arthurmlima/iceOv7670Tft/README.md

# Tang Primer 25K OV7670 → ST7789 Live Camera Stream

Pure-Verilog live camera viewfinder for the **Sipeed Tang Primer 25K**
(Gowin GW5A-25A, on the 25K Dock): an OV7670 camera is streamed straight to
an ST7789 TFT/IPS panel with **no CPU, no external RAM, and no full frame
buffer**. The ST7789's own GRAM is the frame store; the FPGA only carries a
small FIFO to absorb the difference between the camera's bursty active-video
timing and the panel's constant SPI drain rate.

```text
OV7670 RGB565 → center-crop 320×240 to 280×240
              → optional frame-seeded XOR-map stage
              → 32768×16 synchronous FIFO (32 GW5A BSRAM)
              → ST7789 RAMWR stream
```

Top-level entity: **`tangprimer25k_st7789_top`**
(`tangprimer25k_st7789_top.v`).

This design was originally built for the iCEBreaker (Lattice iCE40UP5K) and
ported here. [§12](#12-what-the-port-changed) is the summary of what had to
change and why; everything between the top level and the pads is the same RTL.

---

## 1. Repository layout

| Path | Role |
|---|---|
| `tangprimer25k_st7789_top.v` | Top level: PLL, POR/reset, camera XCLK, ODDR SPI pad cells, SCCB IO buffer, buttons, status LEDs |
| `gowin_pll_40m.v` | `PLLA` wrapper: 50 MHz dock oscillator → 40 MHz `clk_sys` |
| `btn_debounce.v` | Synchronizer + integrate-and-commit debouncer for one pushbutton |
| `status_led.v` | Turns the two board LEDs into a frame heartbeat and a blink-coded fault index |
| `test_pattern_src.v` | Frame-static diagnostic pattern with the camera's exact timing |
| `tangprimer25k_pattern_top.v` | Diagnostic top: same design, `test_pattern_src` instead of the camera |
| `cam_init.v` | OV7670 SCCB (I²C-like) master — writes the register table on power-up |
| `cam_capture.v` | Synchronizes PCLK/HREF/VSYNC, assembles RGB565 bytes, crops 320→280 columns |
| `frame_stream_gate.v` | Atomically accepts a frame only when the display is ready; drops busy-time frames without flushing/mixing FIFO data |
| `pixel_xor_stage.v` | Per-frame seed generator, frame-safe bypass mux, and pixel/XOR-map integration |
| `xormap_32.v` | Iterative 32-bit XOR map with a 16-bit folded output |
| `pixel_fifo.v` | 32768×16 single-clock FIFO absorbing the camera/panel rate difference (infers 32 BSRAM) |
| `st7789_camera_ctrl.v` | ST7789 reset/init/address-window FSM, streams FIFO pixels into RAMWR |
| `st7789_init_rom.v` | Combinational ROM: the known-working ST7789 register-init sequence |
| `spi_stream_tx.v` | Gapless mode-0 SPI byte engine, one bit per `clk_sys` cycle; device-independent (the DDR pad cells live in the top level) |
| `tangprimer25k.cst` | Physical constraints — pin table in [§7](#7-wiring--pinout) |
| `tangprimer25k.sdc` | Timing constraints |
| `tangprimer25k.gprj` | Gowin project file (device + source list) |
| `build.tcl` | Headless `gw_sh` script: sets the dedicated-pin overrides, then `run all` |
| `Makefile` | `gw_sh` → `openFPGALoader` build/program flow, plus `sim` and `timing` |
| `tb_spi_gowin_io.v` | Pad-level testbench for the ODDR SPI cells (see [§4.2](#42-spi-pad-cells-sb_io--oddr)) |
| `tb_frame_recovery.v` | Reproduces the starved-frame deadlock and proves the watchdog clears it |
| `build_pattern.tcl` | `build.tcl` with the diagnostic top selected |
| `timing_check.py` | Recomputes the clock/line-rate/FIFO-margin numbers in [§4](#4-clock-plan) and [§5](#5-line-rate-proof) |
| `docs/SETUP.md` | One-time Gowin CLI toolchain setup on macOS, and board notes |
| `docs/install-gowin-cli.sh` | Idempotent installer for that setup |
| `unused/` | RTL **not** part of the build — see [§1.1](#11-unused--reference-rtl) |

### 1.1 Unused / reference RTL

`unused/` holds the earlier standalone ST7789 test-pattern design this was
built from, plus the retired iCE40 build. None of it is in the Makefile's
`SOURCES` list or `tangprimer25k.gprj`.

| Path | Role |
|---|---|
| `unused/icebreaker_st7789_top.v` | The iCE40UP5K top level this port replaced (`SB_PLL40_PAD` + `SB_IO` cells) |
| `unused/icebreaker.pcf` | Its nextpnr pin constraints |
| `unused/st7789_rgb_test.v` | Old standalone top: reset + init ROM + CASET/RASET/RAMWR + a combinational test-pattern generator, no camera |
| `unused/rgb_test_pattern.v` | Combinational RGB565 test-pattern generator instantiated only by `st7789_rgb_test.v` |
| `unused/spi_master_tx.v` | Older one-cycle-per-bit SPI engine (superseded by `spi_stream_tx.v`'s DDR engine) |
| `unused/timing_39MHz.patch` | Historical iCE40 PLL patch, kept only for the record |

---

## 2. Module tree

```text
tangprimer25k_st7789_top                     (PLL, POR/reset, XCLK gen, LEDs, pad cells)
│
├─ gowin_pll_40m  "pll"                       50 MHz → 40 MHz clk_sys
│    └─ PLLA                                  [GW5A primitive]
│
├─ btn_debounce  "s2_button"                  S2 → one clean toggle pulse per press
│
├─ status_led  "status"                       frame heartbeat + blink-coded fault
│
├─ cam_init  "camera_config"                  OV7670 SCCB register-write master
│    (drives cam_sioc directly; siod_low → IOBUF below)
│
├─ IOBUF  "cam_siod_io"                       [GW5A primitive] open-drain SCCB data pin
│
├─ cam_capture  "capture"                     RGB565 capture / crop / frame-sync
│    (enable = stream_enable = cam_cfg_done && lcd_init_done)
│
├─ frame_stream_gate  "frame_gate"            accept ready frames / drop busy frames
│
├─ pixel_xor_stage  "encryption"              optional frame-seeded pixel XOR
│    └─ xormap_32  "map"                      iterative 32-bit XOR map
│
├─ pixel_fifo  "fifo"                         32768×16 surplus FIFO (32 BSRAM)
│
├─ st7789_camera_ctrl  "display"              ST7789 reset/init/window/pixel-stream FSM
│    ├─ st7789_init_rom  "init_rom"           combinational panel-init byte ROM
│    └─ spi_stream_tx  "spi"                  gapless mode-0 SPI bit engine
│
├─ ODDR  "tft_sclk_io"                        [GW5A primitive] → tft_scl  (SCLK)
├─ ODDR  "tft_mosi_io"                        [GW5A primitive] → tft_sda  (MOSI)
├─ ODDR  "tft_dc_io"                          [GW5A primitive] → tft_dc
└─ ODDR  "tft_cs_io"                          [GW5A primitive] → tft_cs
```

`tft_res` and `tft_blk` are driven straight from the top level; they only move
on millisecond timescales, so they need no pad retiming.
`tft_blk` is `assign tft_blk = BL_ACTIVE_HIGH ? bl_raw : ~bl_raw;`, where
`bl_raw` comes from `st7789_camera_ctrl`'s `tft_bl` output.

---

## 3. Block diagram

```mermaid
flowchart LR
    subgraph CLK["Clock generation"]
        OSC["50 MHz\ndock oscillator (E2)"] --> PLL["PLLA\nIDIV=1 FBDIV=1\nMDIV=24 ODIV0=30"]
        PLL --> SYS["clk_sys\n40.00 MHz"]
        SYS -- "ODDR pad copy" --> XCLKW["cam_xclk\n40.000 MHz\nsensor ÷2 → f_int 20 MHz"]
    end

    subgraph RST["Reset"]
        BTN["S1 (H11)\nactive high"] --> SYNC["2-FF sync +\nPOR counter"]
        PLL -. LOCK .-> SYNC
        SYNC --> RESETN["resetn / rst"]
    end

    XCLKW --> CAM["OV7670 camera"]

    SCCB["cam_init\n(SCCB master)"] <-- "sioc / siod" --> CAM
    SCCB -- cam_cfg_done --> EN{{stream_enable\n= cfg_done AND init_done}}

    CAM -- "cam_d[7:0], pclk, href, vsync" --> CAP["cam_capture\n(sync, RGB565 assemble,\n320→280 crop)"]
    EN -. enable .-> CAP

    CAP -- "pix_wr + frame_sync" --> GATE["frame_stream_gate\naccept only when LCD ready"]
    CTRL -. stream_active .-> GATE
    BTN2["S2 (H10)\ndebounced toggle"] --> ENC
    CAP -- "pix_data[15:0]" --> ENC["pixel_xor_stage\nframe seed + XOR/bypass"]
    GATE -- "accepted pixel valid" --> ENC
    CAP -- frame_sync --> ENC
    GATE -- "accepted frame_sync" --> FIFO["pixel_fifo\n32768×16 (32 BSRAM)"]
    ENC -- "pixel[15:0], valid" --> FIFO
    GATE -- "accepted frame_sync" --> CTRL

    FIFO -- "rd_data[15:0], rd_valid" --> CTRL["st7789_camera_ctrl\n(reset/init/window FSM)"]
    ROM["st7789_init_rom"] --> CTRL
    EN -. stream_enable .-> CTRL

    CTRL --> SPI["spi_stream_tx\n(gapless mode-0, 1 bit/clk_sys)"]
    SPI --> IOC["4x ODDR pad cells\nSCLK, MOSI, DC, CS"]
    IOC --> TFT["ST7789 panel"]
    CTRL -- "tft_bl" --> BLMUX{{"BL_ACTIVE_HIGH\nmux"}} --> TFT

    CTRL -- init_done --> EN
    CTRL -- lcd_sync_error --> FAULT{{"stream_fault =\noverflow OR underflow\nOR sync_error\nOR dropped frame"}}
    FIFO -- overflow/underflow --> FAULT
    EN --> LEDR["READY LED (E8)"]
    FAULT --> LEDD["DONE LED (D7)"]
```

The camera/display datapath runs entirely in the single `clk_sys` (40.00 MHz)
domain — `cam_pclk` is sampled as synchronized *data*, never used as an RTL
clock. Both buttons pass through synchronizers before entering any logic.

---

## 4. Clock plan

| Clock | Value | Source |
|---|---:|---|
| Dock oscillator | 50.000 MHz | Tang Primer 25K Dock, pin E2 |
| FPGA system clock (`clk_sys`) | 40.000 MHz | `PLLA` |
| ST7789 SCLK | 40.000 MHz | `clk_sys`, via DDR SPI engine |
| OV7670 XCLK | 40.000 MHz | `clk_sys`, via `ODDR` pad cell (`CAM_XCLK_DIV=1`) |
| OV7670 internal clock | 20.000 MHz | XCLK / 2 — this sensor's fixed divide, with `CAM_CLKRC=0x00` (prescale ÷1) |
| OV7670 PCLK | 10.000 MHz | QVGA scaling, PCLK / 2 |

PLL settings: `IDIV_SEL=1`, `FBDIV_SEL=1`, `MDIV_SEL=24`, `ODIV0_SEL=30`
(`f_vco = 50 MHz × 24 = 1200 MHz`, `f_out = 1200 / 30 = 40 MHz`).

### 4.1 Why 40.00 MHz, and why 25 fps

Frame rate depends on exactly one thing:

```text
fps = f_int / 799,680          (510 lines × 1568 internal clocks)
```

The OV7670's frame period is a fixed number of internal clocks. QVGA decimates
the *output*; it does not shorten the array scan. So nothing about the panel,
the SPI rate or the crop changes the frame rate — only `f_int` does.

`clk_sys` is therefore chosen by the panel rather than by frame rate: ST7789
SCLK at 40 MHz (the iCE40 build's proven 39 MHz, rounded to a clean PLL
ratio). Running `clk_sys` straight off the 50 MHz oscillator would push SCLK
to 50 MHz, which is headroom the panel has not been tested at here.

**What changed from the iCEBreaker design.** It ran `f_int` at `clk_sys/4`
(XCLK = `clk_sys/2`, then `CLKRC = /2`), which made the camera's active-video
pixel rate exactly equal to the panel's drain rate:

```text
camera pixel rate = f_int/4 = clk_sys/16
panel  pixel rate = SPI/16  = clk_sys/16     ← identical, by construction
```

With the rates identical the FIFO never accumulates — one pixel in, one out —
which is why 256 entries sufficed. But that same balance pinned the frame rate
at 12.5 fps while the panel could sustain 37.2.

`f_int` is now 20 MHz, so the frame rate is **25.0 fps**. The camera outruns
the panel during active video, and the surplus has to be held — see
[§5](#5-frame-rate-and-buffering). That surplus is the *only* reason the FIFO
grew; nothing else in the datapath changed.

#### How `f_int` gets to 20 MHz — and why not via `CLKRC`

The obvious route is XCLK = `clk_sys/2` = 20 MHz with the `CLKRC` prescaler at
÷1. It does not work, because **the sensor fitted here divides XCLK by 2 more
than the datasheet says.** One hardware measurement establishes that, and it
is the only camera-clock measurement this design has:

| XCLK | `CLKRC` | prescale asked for | expected `f_int` | measured |
|---:|---:|---:|---:|---:|
| 20 MHz | `0x00` | ÷1 | 20 MHz | **10 MHz** — PCLK 5 MHz, VSYNC 12.5 Hz, HREF 3.19 kHz |

The three measured numbers are mutually consistent (`PCLK = f_int/2`,
`fps = f_int/799,680`, and HREF at half the line rate as QVGA DCW implies), so
that is genuinely `f_int` and not a mis-read. A lost SCCB write does not
explain it: `CLKRC`'s reset default (`0x80`) has a zero prescale field too, so
a write that never landed would still have given ÷1, and `PCLK/HREF = 1568`
proves the QVGA/DCW writes in the same table *do* land. The likeliest
mechanism is the reserved bit[7], which resets to 1 and which `0x00` clears —
unconfirmed.

What is *not* known is whether the prescale field works on this part at all.
So the design moves exactly one variable away from the measured baseline:
`CLKRC` keeps the `0x00` that was measured, and XCLK carries the factor of two
instead.

```text
XCLK = clk_sys = 40 MHz  →  sensor ÷2  →  f_int = 20 MHz  →  25.01 fps
```

40 MHz is inside the sensor's 10–48 MHz XCLK range. `clk_sys` cannot come out
of a fabric flop at full rate, so `cam_xclk` is emitted from an `ODDR` pad
cell (`D0=1, D1=0`), the same primitive the SPI pads use.

`CAM_XCLK_DIV = 1` and `CAM_CLKRC = 0x00` are the two halves of this. If the
÷2 is real and fixed, they must thereafter **move together** — doubling XCLK
while adding a prescale ÷2 cancels exactly, and lands back on 12.5 fps.
`CAM_INT_DIV`, and through it the test-pattern source's line/pixel timing, is
derived from `CAM_XCLK_DIV × 2 × prescale`, so the rest of the design follows
automatically; `timing_check.py` mirrors the same chain and asserts 25 fps.

**Verify XCLK on the pin before interpreting anything downstream.** It must
read 40 MHz. If it reads 20 MHz the running bitstream is not this design, and
no register value can matter — see the note on `make prog` vs `make flash` in
[§8](#8-build-and-programming). If XCLK is 40 MHz and PCLK comes out at
20 MHz rather than 10, there is no fixed ÷2 after all and `CAM_XCLK_DIV=2` is
the answer.

The remaining step to 30 fps (the OV7670's rated QVGA maximum) is not a
register change. `PCLK` is `clk_sys/4` at 25 fps — structurally, whatever
`clk_sys` is — and that is the floor for `cam_capture`'s 2-flop sampling of
PCLK as data. Going faster means clocking *on* PCLK instead of sampling it,
i.e. a genuine second clock domain.

`USE_PLL=0` bypasses the PLL and clocks the design from the raw 50 MHz
oscillator; if you do that, override `SYS_CLK_HZ` and `SPI_HZ` to `50000000`
so the millisecond and SCCB dividers stay correct — and note that it also puts
XCLK at 50 MHz, past the sensor's 48 MHz maximum, so `CAM_XCLK_DIV=2` becomes
mandatory (at 12.5 fps, unless that sensor honours `CLKRC`).

### 4.2 SPI pad cells: `SB_IO` → `ODDR`

`spi_stream_tx` emits one bit per `clk_sys` cycle, so SCLK has to toggle at
the full `clk_sys` rate and cannot come out of ordinary fabric flops. On iCE40
that was an `SB_IO` DDR cell for SCLK plus `NEG_TRIGGER` (falling-edge) cells
for MOSI/DC. Gowin's `ODDR` drives `D0` while the clock is high and `D1` while
it is low, which reproduces the same "SCLK = active AND clk_high"
one-discrete-pulse-per-bit behaviour.

What does *not* carry over is latency: an `SB_IO` output register is one cycle
deep, Gowin's `ODDR` is three. Two consequences, both handled in the top level:

1. **MOSI/DC still have to lead SCLK by half a cycle.** Feeding `D0` with the
   bit delayed one cycle and `D1` with the undelayed bit puts the pad
   transition in the middle of the cycle before the pulse. Writing `b(N)` for
   the bit presented in cycle N: MOSI holds `b(N)` from mid-cycle N+3 to
   mid-cycle N+4, and SCLK (fed the *delayed* "active" flag, so its pulse for
   `b(N)` lands in cycle N+4) rises at the start of cycle N+4 — half a cycle
   of setup and half a cycle of hold, as on iCE40.
2. **CS has to move with the data.** `st7789_camera_ctrl` deasserts `tft_cs_n`
   two cycles after the last bit's cycle. That was safe when the pad trailed
   the fabric by one cycle and is *not* safe at four: CS would rise two cycles
   before the final SCLK pulse and truncate the last byte of every burst.
   Routing CS through its own `ODDR` gives it the identical path.

`tb_spi_gowin_io.v` (`make sim`) checks all of this at the pads against
Gowin's own `ODDR` behavioural model from `simlib/gw5a/prim_sim.v`, the way
the iCE40 build checked itself against `SB_IO` in `cells_sim.v`. It drives the
real `st7789_camera_ctrl` through a full reset → init → window → pixels → idle
cycle (shrunk to an 8×2 window) and asserts that every byte reconstructed by
clocking MOSI on SCLK edges matches the byte `spi_stream_tx` accepted, that
MOSI/DC are stable either side of every sampling edge, that CS is low at every
edge, and that SCLK pulses are discrete rather than merged. Three deliberately
broken variants (CS without the matching cell, MOSI without the mid-cycle
split, SCLK without the extra delay) were each confirmed to fail it, so the
test is not vacuous.

---

## 5. Frame rate and buffering

```text
frame rate        = 20.000 MHz / 799,680        = 25.01 fps
camera frame      = 799,680 / 20.000 MHz        = 39.98 ms
panel frame       = 280 × 240 × 16 / 40.000 MHz = 26.88 ms  (ceiling 37.2 fps)
                                                  13.10 ms to spare
```

The panel comfortably finishes each frame before the next VSYNC, so no frames
are dropped. What it cannot do is keep up *during* active video:

```text
active video span = 240 × 1568 / 20.000 MHz     = 18.82 ms   (worst case)
pixels in         = 280 × 240                   = 67,200
pixels drained    = 18.82 ms × 40 MHz / 16      = 47,040
peak FIFO         =                               20,160 pixels
```

Hence `FIFO_DEPTH = 32768` (62% used, 32 of 56 BSRAM blocks, 51% of the
device's 1008 Kb). A *full* 280×240×16 framebuffer would be 1050 Kb and would
not fit — but it is not needed, only the deficit is.

That figure is the safe side of an open question: it assumes the sensor emits
its 240 QVGA output lines in consecutive line periods. Vertical DCW decimation
suggests it actually spreads them over 480, in which case the panel keeps up
throughout and the FIFO only holds an intra-line ripple of ~140 pixels. Sizing
for the pessimistic case costs BSRAM the device has to spare.

Run:

```sh
make timing        # python3 timing_check.py
```

to recompute all of the above from the live clock parameters. It asserts the
two conditions that must hold — the panel finishing inside a camera frame, and
the deficit fitting in the FIFO — so it fails loudly if a clock is retuned
without resizing the buffer.

---

## 6. Display geometry & camera configuration

- Panel operated in landscape mode: `MADCTL = 0xA0`.
- Visible stream: 280 × 240 pixels. `CASET = 20..299`, `RASET = 0..239`.
- Camera: QVGA 320 × 240 RGB565 (`COM7 = 0x14`); crop removes 20 columns
  from each horizontal side.
- Pixel format: RGB565, high byte first (swap `{hi_byte, d_s1}` in
  `cam_capture.v` if colors come out byte-swapped on your unit).
- ST7789 hardware reset timing and init register sequence are retained
  byte-for-byte from the working display-only project.

### Frame-seeded XOR-map stage

For an accepted encrypted frame, the accepted `cam_capture.pix_wr` strobe
advances `xormap_32` exactly once per retained RGB565 pixel. In bypass mode
the map does not load or advance. The accepted-frame pulse loads a new 32-bit
seed before the first pixel. The seed generator is a nonzero 32-bit LFSR
stepped once per accepted frame, so it produces a deterministic pseudo-random
seed sequence from `XORMAP_INITIAL_SEED`; it is not a hardware true-random
generator.

The runtime mode is frame-safe: **S2 toggles encryption on/off**, and the
request takes effect on the next accepted frame boundary, never partway
through the current image. Reset returns to `ENCRYPTION_DEFAULT` (default `0`,
bypass). Setting the top-level `ENABLE_XORMAP` parameter to `0` makes the
encryption stage a hard pass-through and allows synthesis to remove the map.

`frame_stream_gate` prevents spatial mixing when camera/display timing slips.
If a new camera frame arrives while the LCD controller is still streaming,
the FIFO is left intact so the old transfer can finish and every pixel from
the new frame is suppressed. The next frame arriving while the LCD is idle is
accepted, flushes stale FIFO contents, and starts a complete new display
window. A rejected frame lights the sticky fault LED.

If a genuine camera fault produces an incomplete accepted frame, the LCD
controller can remain waiting for its missing pixels. Use **S1** to recover
from that persistent fault-LED condition; ordinary busy-frame rejection
recovers automatically at the next ready frame.

There is no decryptor after the FIFO, so the display intentionally shows
scrambled RGB565 values while the stage is enabled. This XOR map is a linear,
32-bit visual scrambler, not a cryptographically secure cipher; applications
requiring confidentiality should use a reviewed cipher and proper key/nonce
management.

Key OV7670 register deltas from the stock reference table (full table in
`cam_init.v`):

| Register | Value | Purpose |
|---|---:|---|
| `COM7` (0x12) | 0x14 | QVGA selection + RGB output |
| `CLKRC` (0x11) | 0x00 | prescale ÷1; sensor's own fixed ÷2 then gives `f_int` = 20 MHz (see [§4.1](#41-why-4000-mhz-and-why-25-fps)) |
| `DBLV` (0x6B) | 0x0A | camera 4× PLL disabled |
| `COM3` (0x0C) | 0x04 | enable downsample/crop (DCW) path |
| `COM14` (0x3E) | 0x19 | manual QVGA scaling, PCLK / 2 |
| `RGB444` (0x8C) | 0x00 | disable RGB444 |
| `COM15` (0x40) | 0xD0 | RGB565, full range |
| `0x70–0x73`, `0xA2` | QVGA set | 320×240 scaling registers |

Color matrix and windowing/scaling registers are carried over verbatim from
a previously proven configuration.

### Image-quality tuning block

The original register table never programmed `COM8`, AEC/banding parameters,
AWB tuning, pixel correction/edge enhancement, or the gamma curve — those all
sat at chip reset defaults, which on the OV7670 tends to show up as a
purple/magenta color cast, exposure hunting or visible banding under
artificial light, salt-and-pepper pixel noise, and flat/washed-out contrast.
`cam_init.v` appends a second block of register writes (entries 61–117 of the
ROM) sourced verbatim from the mainline Linux kernel `ov7670` driver's default
register set — the most widely deployed, long-proven OV7670 tuning reference —
restricted to registers that don't touch this design's timing-critical
settings (`CLKRC`, `COM7`, `COM3`, `COM14`, the window/scaling registers,
`DBLV`):

| Block | Registers | Purpose |
|---|---|---|
| AEC operating region / banding | `AEW`, `AEB`, `VPT`, `COM11`, `BD50MAX`, `BD60MAX`, `HAECC1-7` | Stable auto-exposure operating range plus 50/60 Hz banding-filter auto-detect |
| Auto-control enable | `COM8` = `0xFF` | Fast AGC/AEC, unlimited AEC step, banding filter, AGC, AEC, AWB |
| AWB tuning | `BLUE`, `RED`, `0x43-0x48`, `0x59-0x5E`, `0x6A`, `0x6C-0x6F`, `COM16` | Standard fix for the OV7670's purple/magenta color cast |
| Pixel correction / edge | `EDGE`, `0x75`, `REG76`, `0x4B`, `0x77`, `0xC9` | `REG76` in particular suppresses white/black speckle noise |
| Gamma curve | `GAM1-15`/`SLOP` (`0x7A-0x89`) | Replaces the flat reset-default tone curve |

Total SCCB table time is ~290 ms at the 100 kHz bit rate — still comfortably
under the ST7789's own ~500 ms init, so `BOOT_TICKS`/`GAP_TICKS`/`RST_TICKS`
did not need re-tuning. Only `TICK_DIV` is clock-dependent, and the top level
computes it as `SYS_CLK_HZ/400000`.

`COM9` (AGC gain ceiling) was deliberately left at its existing `0x38`
(16× ceiling) rather than the Linux driver's more conservative `0x18` (4×):
a higher ceiling brightens low-light video at the cost of more visible
sensor noise/grain. If graininess in dim conditions is part of the
"quality" complaint, lowering `COM9`'s bits `[6:4]` is the next knob to try.

---

## 7. Wiring / pinout

Tang Primer 25K PMOD signals are 3.3 V. Use an OV7670 breakout explicitly
rated for 3.3 V logic — a bare sensor needs its own rails and level
translation. Connect camera and display grounds together, and never expose
FPGA pins to more than 3.3 V.

All three PMOD headers are used: **J4 and J5 carry the OV7670** (one row of
the sensor's ribbon header each) and **J6 carries the ST7789**. On every PMOD,
**p5/p11 are GND and p6/p12 are +3V3**; the eight signal pins are p1–p4 and
p7–p10:

```text
         p1  p2  p3  p4  p5(GND)  p6(3V3)
         p7  p8  p9  p10 p11(GND) p12(3V3)
```

### PMODs J4 + J5 — OV7670

The camera's 18-pin (2×9) ribbon header is split one row per PMOD, in the
sensor board's own pin order, so a ribbon cable maps straight across. The two
supply pins come off the PMOD power pins, leaving exactly the eight signals
per row that a PMOD carries.

**J4 — OV7670 odd row**

| OV7670 header | PMOD pin | FPGA ball | Signal |
|---|---|---|---|
| 3V3 | p6 / p12 | — | +3V3 |
| SIOC | p1 | G11 | `cam_sioc` (SCCB clock) |
| VSYNC | p2 | D11 | `cam_vsync` |
| PCLK | p3 | B11 | `cam_pclk` |
| D7 | p4 | C11 | `cam_d[7]` |
| D5 | p7 | G10 | `cam_d[5]` |
| D3 | p8 | D10 | `cam_d[3]` |
| D1 | p9 | B10 | `cam_d[1]` |
| RESET | p10 | C10 | `cam_rst_n` |

**J5 — OV7670 even row**

| OV7670 header | PMOD pin | FPGA ball | Signal |
|---|---|---|---|
| GND | p5 / p11 | — | GND |
| SIOD | p1 | A11 | `cam_siod` (SCCB data) |
| HREF | p2 | E11 | `cam_href` |
| XCLK | p3 | K11 | `cam_xclk` |
| D6 | p4 | L5 | `cam_d[6]` |
| D4 | p7 | A10 | `cam_d[4]` |
| D2 | p8 | E10 | `cam_d[2]` |
| D0 | p9 | L11 | `cam_d[0]` |
| PWDN | p10 | K5 | `cam_pwdn` |

The 8-bit data bus therefore lands interleaved across two connectors — odd
bits on J4, even bits on J5. That is purely a wiring convenience;
`cam_capture` samples the bus synchronously and does not care where the bits
sit.

`cam_siod` is open-drain (driven low only, released otherwise) and uses the
pin's internal pull-up (`PULL_MODE=UP`); a 4.7 kΩ external pull-up to 3.3 V
may help if SCCB wiring is long. `cam_sioc` is push-pull.

### PMOD J6 — ST7789 display

| PMOD pin | FPGA ball | Signal |
|---|---|---|
| p1 | F5 | `tft_blk` (backlight) |
| p2 | G7 | `tft_cs` |
| p3 | H8 | `tft_dc` |
| p4 | H5 | `tft_res` |
| p7 | G5 | `tft_sda` (MOSI) |
| p8 | G8 | `tft_scl` (SCK) |
| p9 | H7 | *unused* |
| p10 | J5 | *unused* |

### Dock board

| Signal | FPGA ball | Notes |
|---|---|---|
| `clk50` | E2 | 50 MHz oscillator; needs `use_cpu_as_gpio` + `use_sspi_as_gpio` |
| `btn_s1` | H11 | Button **S1**, active high (100R to +3V3, internal pull-down) |
| `btn_s2` | H10 | Button **S2**, active high |
| `led_ready` | E8 | READY status LED; needs `use_ready_as_gpio` |
| `led_done` | D7 | DONE status LED; needs `use_done_as_gpio` |

> **Provenance.** The PMOD tables above come from the dock schematic
> (`Tang_Primer_25K_Dock_60033_Schematic.pdf`, sheet 1), converted from the
> schematic symbol's pin numbering to physical header numbering, and
> cross-checked two ways: against litex-boards'
> `sipeed_tang_primer_25k` connector definitions, and against Sipeed's own
> `pmod_lcd`, `pmod_hub75e`, `nestang-25k` and `hdmi` examples (whose
> differential HDMI pairs land on vertically adjacent header pins exactly as
> this table predicts). The button nets are literally named `H11_IOT3A_S1`
> and `H10_IOT3B_S2` in the schematic. Sipeed's `pmod_led` example is *not* a
> reliable source — see `docs/SETUP.md`.
>
> One thing that is **not** verified from a primary source: whether the
> READY/DONE LEDs light on a logic 1 or a logic 0. `LED_ACTIVE_HIGH` (default
> `1`) flips it; if the two status LEDs read inverted on your board, set it
> to `0`. Nothing else depends on this.

---

## 8. Build, simulate and program

Required tools: `gw_sh` (Gowin IDE, headless) and `openFPGALoader`. See
`docs/SETUP.md` for the one-time macOS setup — including *why* `gw_sh` needs
a wrapper script — and run `bash docs/install-gowin-cli.sh` to do it.
`make sim` additionally needs `iverilog`.

```sh
make               # gw_sh build.tcl -> impl/pnr/tangprimer25k.fs
make prog          # openFPGALoader -b tangprimer25k  ... (SRAM, volatile)
make flash         # openFPGALoader -b tangprimer25k -f ... (SPI flash, persists)

make pattern       # diagnostic build: test pattern instead of the camera
make prog-pattern  # load it

make sim           # both testbenches
make sim-spi       # pad-level ODDR SPI phase
make sim-recovery  # starved-frame deadlock / watchdog
make timing        # python3 timing_check.py
make clean         # rm -rf impl
```

**`make prog` does not survive a power cycle.** It configures SRAM only; the
FPGA reloads from SPI flash on every power-up and on any reconfigure, so a
board that is unplugged, reset, or re-powered between programming and
measuring is running the *old* image, not the one just built. If measurements
do not move after a rebuild, this is the first thing to rule out — use
`make flash`, and confirm with a signal that changed by construction:

```sh
make flash
# then, on a scope: cam_xclk (J5 p3) must read 40.000 MHz.
# 20 MHz means the running bitstream predates the 25 fps work.
```

`make pattern` swaps in `test_pattern_src` — same pins, same constraints, same
downstream RTL, but a known frame-static picture with the camera's exact pixel,
line and frame timing. It bisects the pipeline: a clean, square, stable grid
means the panel, SPI pads, FIFO, frame gate and panel FSM are all correct and
any fault is the camera, its SCCB configuration, or `cam_capture`. It also runs
with no camera attached, since SCCB is write-only and never checks for an ACK.

`build.tcl` releases the four dedicated pins this design needs
(`use_cpu_as_gpio`, `use_sspi_as_gpio`, `use_ready_as_gpio`,
`use_done_as_gpio`) and nothing else — JTAG stays JTAG, so the board remains
reprogrammable.

---

## 9. Status LEDs, buttons, and backlight

The dock has no general-purpose user LED, so the two configuration-status
LEDs are repurposed:

Two LEDs cannot localise a fault by being on or off, so they carry patterns
instead (`status_led.v`):

- **READY LED (E8)**
  - *short pulse every 1.5 s* — alive, but SCCB config and/or panel init not
    finished. Deliberately slow and asymmetric so it cannot be mistaken for
    the flicker below.
  - *rapid flicker* — frames are completing. It toggles once per frame, so
    ~12.5 Hz at 25 fps.
  - *steady on or off* — initialisation finished but frames are **not**
    completing; the panel stream is stalled.
- **DONE LED (D7)** — off means no fault has latched. Otherwise it blinks the
  index of the *first* sticky fault, pauses, and repeats:

  | Blinks | Fault | Meaning |
  |---:|---|---|
  | 1 | FIFO overflow | camera outran the panel and the buffer filled |
  | 2 | FIFO underflow | panel read an empty FIFO |
  | 3 | frame starved | pixels stopped arriving mid-frame; the watchdog aborted it |
  | 4 | LCD sync error | a VSYNC arrived during a transfer |
  | 5 | frame dropped | panel was still busy at VSYNC |

  Indices are ordered so root causes blink fewer times than their
  consequences: 1–3 will also produce 4 and 5, so seeing 4 or 5 *alone* means
  something different from seeing them after a 1.
- **S1** — full camera and panel reset/reinitialization (also gated by the
  PLL lock and a POR counter on power-up).
- **S2** — toggle XOR-map encryption; applies at the next frame boundary.
- **Backlight (`tft_blk`)** — driven low (off) through the hardware reset
  pulse, then turned on by `st7789_camera_ctrl` as soon as the init FSM
  finishes walking `st7789_init_rom` (before the first frame streams, but
  after `SWRESET`/`SLPOUT`/gamma/`DISPON` have been sent) — it never turns
  off again afterward. `BL_ACTIVE_HIGH` (top-level parameter, default 1)
  controls the polarity of the physical pin; the ST7789 panel is a
  transmissive IPS LCD, so with the backlight off the panel shows nothing
  even though the controller is still updating GRAM normally.

---

## 10. Bring-up checklist

1. Verify `cam_xclk` (J5 p3) is approximately 40.000 MHz (20.000 MHz if built
   with `CAM_XCLK_DIV=2`).
2. Verify `cam_sioc` (J4 p1) activity after reset and that the READY LED
   eventually turns on.
3. Verify `cam_pclk` (J4 p3) is approximately 10.000 MHz. This is the single
   number that decides the frame rate — `f_int = 2 × PCLK` and
   `fps = f_int/799,680` — so check it before believing anything else:

   | PCLK | `f_int` | fps | meaning |
   |---:|---:|---:|---|
   | 10 MHz | 20 MHz | 25.0 | correct |
   | 5 MHz | 10 MHz | 12.5 | sensor divided XCLK by 4, not 2 — check XCLK really is 40 MHz, then `CAM_CLKRC` really is `0x00` ([§4.1](#41-why-4000-mhz-and-why-25-fps)) |
   | 20 MHz | 40 MHz | 50 | the fixed ÷2 is absent on this part; `cam_capture` cannot sample this — set `CAM_XCLK_DIV=2` |

   VSYNC and HREF are worth cross-checking but neither is a substitute: VSYNC
   is a narrow pulse that cheap counters mis-trigger on, and in QVGA HREF runs
   at half the line rate (`PCLK/HREF = 1568` when DCW is working).
4. Verify `tft_scl` (J6 p8) is a clean ~40 MHz square wave while streaming,
   with no runt/merged pulses — this is the first place a DDR phase mistake
   would show up. If the panel shows garbled or shifted color data instead
   of a recognizable (if unsynced) image, suspect the ODDR timing in the top
   level before anything else, and re-run `make sim`.
5. If the image colors are byte-swapped, change `{hi_byte, d_s1}` to
   `{d_s1, hi_byte}` in `cam_capture.v`.
6. If the image is mirrored or upside down, try ST7789 `MADCTL=0x60` or
   adjust OV7670 `MVFP` register `0x1E`.
7. If the DONE LED turns on, probe XCLK/PCLK first; the design depends only on
   the camera dividing XCLK by 2, not on it accepting any particular `CLKRC`
   or `DBLV` value.
8. If both status LEDs read inverted (fault LED on at rest, ready LED off
   once streaming), set `LED_ACTIVE_HIGH=0`.
9. If the picture is wrong in any way, run `make pattern && make prog-pattern`
   before debugging anything else — it splits the pipeline in half. The grid's
   verticals must be vertical: if they lean by N pixels over the 240 rows, the
   stream is losing N/240 pixels per row, which is a real defect. If the grid
   is clean, the whole downstream half is proven and the camera is at fault.

---

## 11. Verification status

**Toolchain results** (Gowin IDE V1.9.11.03 Education, `GW5A-LV25MG121NC1/I0`,
device version A):

| | |
|---|---|
| Logic | 856 / 23040 (4%) |
| Registers | 460 / 23280 (2%) |
| BSRAM | 33 / 56 (59%) — 32 SDPB (`pixel_fifo`), 1 pROM (`st7789_init_rom`) |
| IOLOGIC | 4 ODDR (SCLK, MOSI, DC, CS) |
| I/O | 27 ports; 14 in, 12 out, 1 inout |
| Timing | 0 setup violations, 0 hold violations |
| Fmax | 145.4 MHz actual vs the 40.0 MHz constraint (3.6× margin) |

The 25K is a much larger and faster part than the iCE40UP5K, so the recurring
`BTN_N → tft_cs` critical path that dictated the iCE40 build's clock choice is
no longer anywhere near binding.

**Simulation.** Both testbenches pass, and both were checked against
deliberately broken variants so they are not vacuous:

- `make sim-spi` — 105 bytes across a full init + address window + pixel burst
  reconstructed bit-exactly at the pads, 840 discrete SCLK pulses (exactly 8
  per byte), CS low at every sampling edge, MOSI/DC stable either side of every
  edge. Three broken pad wirings (CS without a matching cell, MOSI without the
  mid-cycle split, SCLK without the extra delay) each fail it.
- `make sim-recovery` — a deliberately short frame must abort and the stream
  must resume with no reset. Passes with the watchdog (3 of 3 frames complete);
  with the watchdog removed the same testbench completes 1 of 3 and hangs,
  which is the deadlock it exists to catch.

The behavioural tests inherited from the iCE40 build still apply to the
unchanged RTL: a complete rejected 280×240 frame (all 67,200 pixel strobes
suppressed without altering retained FIFO/map state), 336,156 frame-path
checks, and an exhaustive bypass test confirming all 65,536 RGB565 values pass
bit-for-bit while the XOR map is idle.

**Confirmed on hardware.** The panel, SPI pads, ODDR phase, FIFO, frame gate
and panel FSM all work: the diagnostic pattern build renders and animates, with
no fault latched on the DONE LED.

**Not confirmed on hardware.** The camera path — SCCB configuration, the
sensor's actual output, and `cam_capture`'s sampling of it — has not yet
produced a verified correct image. The 25 fps figure above is derived, not
measured. Also open: the status-LED polarity (`LED_ACTIVE_HIGH`), and whether
your dock silkscreens the three PMOD headers in the same order as the
schematic's J4/J5/J6.

---

## 12. What the port changed

Everything between `cam_capture` and `spi_stream_tx` is byte-identical RTL;
only the device-specific edges moved.

| Area | iCEBreaker (iCE40UP5K) | Tang Primer 25K (GW5A-25A) |
|---|---|---|
| Top level | `icebreaker_st7789_top.v` | `tangprimer25k_st7789_top.v` |
| Oscillator | 12 MHz | 50 MHz (E2) |
| PLL | `SB_PLL40_PAD`, DIVR/DIVF/DIVQ → 39.00 MHz | `PLLA`, IDIV/FBDIV/MDIV/ODIV0 → 40.00 MHz |
| SPI SCLK pad | `SB_IO` DDR cell | `ODDR` + one-cycle input delay |
| SPI MOSI/DC pads | `SB_IO` `NEG_TRIGGER` cells | `ODDR` with delayed `D0` / live `D1` |
| SPI CS pad | plain output | `ODDR`, to match the deeper pad latency |
| SCCB data pin | `SB_IO` open-drain + `PULLUP` | `IOBUF` + `PULL_MODE=UP` |
| Reset button | `BTN_N`, active low | **S1** (H11), active high |
| Encryption control | BTN1 sets, BTN3 clears (bounce-immune by construction) | **S2** (H10) toggles, via `btn_debounce.v` |
| Status LEDs | `LEDG_N`/`LEDR_N`, active low | READY (E8) / DONE (D7), `LED_ACTIVE_HIGH` |
| Pixel FIFO | 256×16, one EBR | 32768×16, 32 BSRAM |
| Starved frame | wedged the pipeline until reset | watchdog aborts the frame, stream resumes |
| Status LEDs | on/off | frame heartbeat + blink-coded fault index |
| Pin constraints | `icebreaker.pcf` (`set_io`) | `tangprimer25k.cst` (`IO_LOC`/`IO_PORT`) |
| Dedicated pins | n/a | `build.tcl` `set_option -use_*_as_gpio` |
| Build flow | yosys → nextpnr-ice40 → icepack → iceprog | `gw_sh` (`build.tcl`) → openFPGALoader |
| Frame rate | ~12.19 fps | **~25.0 fps** (XCLK doubled to 40 MHz; see [§4.1](#41-why-4000-mhz-and-why-25-fps)) |

The one genuinely new failure mode the port introduced — and fixed — is CS
truncating the last byte of every SPI burst, because Gowin's `ODDR` pipeline
is three cycles deeper than `SB_IO`'s output register while the controller's
"deassert CS two cycles after the last bit" logic stayed the same. See
[§4.2](#42-spi-pad-cells-sb_io--oddr).
