arthurmlima/iceOv7670Tft/impl/gwsynthesis/tangprimer25k_syn_resource.html

# Hierarchy Module Resource

MODULE NAME | REG NUMBER | ALU NUMBER | LUT NUMBER | DSP NUMBER | BSRAM NUMBER | SSRAM NUMBER | ROM16 NUMBER
tangprimer25k_st7789_top (/Users/arthur/tangprimer25k/tangprimer25k_st7789_top.v) | 27 | 18 | 12 | - | - | - | -
|--g_pll.pll (/Users/arthur/tangprimer25k/tangprimer25k_st7789_top.v) | - | - | - | - | - | - | -
|--s2_button (/Users/arthur/tangprimer25k/tangprimer25k_st7789_top.v) | 23 | 18 | 13 | - | - | - | -
|--camera_config (/Users/arthur/tangprimer25k/tangprimer25k_st7789_top.v) | 73 | 12 | 100 | - | 1 | - | -
|--g_camera.capture (/Users/arthur/tangprimer25k/tangprimer25k_st7789_top.v) | 71 | - | 41 | - | - | - | -
|--frame_gate (/Users/arthur/tangprimer25k/tangprimer25k_st7789_top.v) | 3 | - | 2 | - | - | - | -
|--encryption (/Users/arthur/tangprimer25k/tangprimer25k_st7789_top.v) | 33 | - | 19 | - | - | - | -
|--g_xormap.map (/Users/arthur/tangprimer25k/pixel_xor_stage.v) | 33 | - | 114 | - | - | - | -
|--fifo (/Users/arthur/tangprimer25k/tangprimer25k_st7789_top.v) | 50 | 28 | 86 | - | 32 | - | -
|--display (/Users/arthur/tangprimer25k/tangprimer25k_st7789_top.v) | 85 | 19 | 266 | - | - | - | -
|--spi (/Users/arthur/tangprimer25k/st7789_camera_ctrl.v) | 15 | - | 17 | - | - | - | -
|--status (/Users/arthur/tangprimer25k/tangprimer25k_st7789_top.v) | 46 | 15 | 70 | - | - | - | -
